YakBizzarro/marelleo/carte/marelleo.kicad_pcb

## KiCad design carte/marelleo.kicad_pcb (2026-11-06)

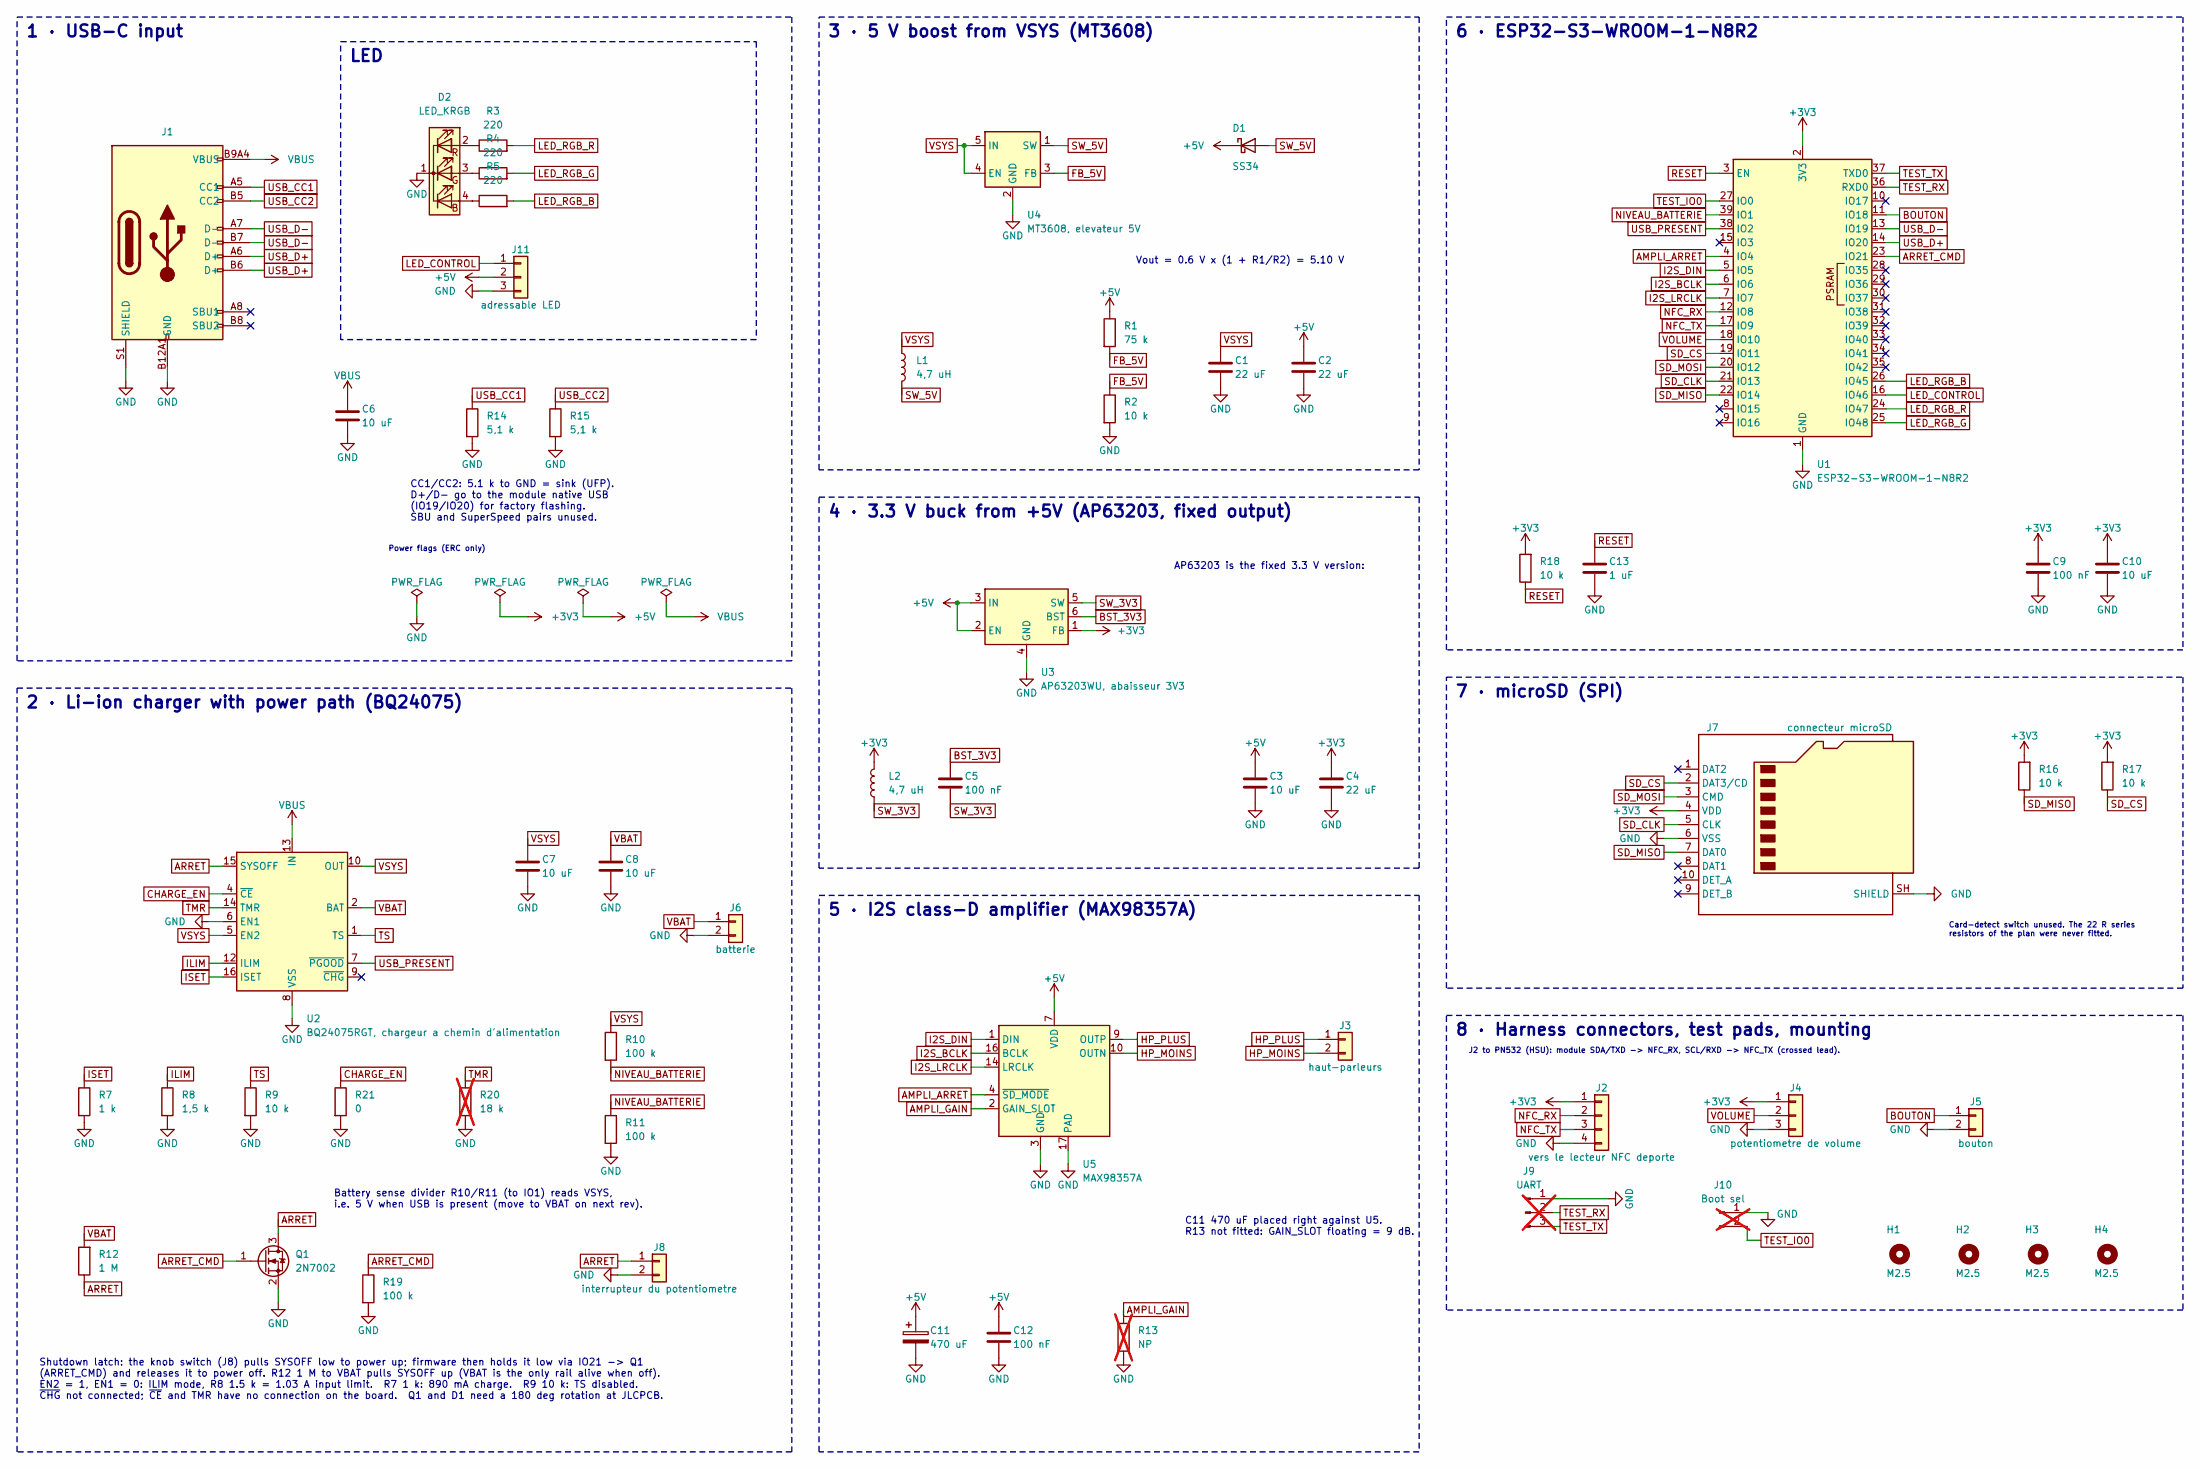
[picture p1: schematic marelleo.kicad_sch, Marelleo - main board]

Parts:
C1, C2, C4: 22 uF; C_0805_2012Metric; LCSC C45783
C3, C6, C7, C8, C10: 10 uF; C_0805_2012Metric; LCSC C15850
C5, C9, C12: 100 nF; C_0603_1608Metric; LCSC C14663
C11: 470 uF; CP_Elec_6.3x7.7; LCSC C82004
C13: 1 uF; C_0603_1608Metric; LCSC C15849
D1: SS34; D_SMA; LCSC C8678
D2: LED_KRGB; LED_D5.0mm-4_RGB_Wide_Pins
H1, H2, H3, H4: M2.5; MountingHole_2.7mm_M2.5
J1: Connector, USB-TYPE-C-16P; TYPE-C-SMD_HX-TYPE-C-16PIN; LCSC C2927039
J2: vers le lecteur NFC deporte; JST_PH_S4B-PH-K_1x04_P2.00mm_Horizontal; LCSC C157926
J3: haut-parleurs; JST_PH_S2B-PH-K_1x02_P2.00mm_Horizontal; LCSC C173752
J4: potentiometre de volume; JST_PH_S3B-PH-K_1x03_P2.00mm_Horizontal; LCSC C157929
J5: bouton; JST_PH_S2B-PH-K_1x02_P2.00mm_Horizontal; LCSC C173752
J6: batterie; JST_PH_S2B-PH-K_1x02_P2.00mm_Horizontal; LCSC C173752
J7: connecteur microSD; microSD_HC_Hirose_DM3AT-SF-PEJM5; LCSC C114218
J8: interrupteur du potentiometre; JST_PH_S2B-PH-K_1x02_P2.00mm_Horizontal; LCSC C173752
J9: UART; PinHeader_1x03_P2.54mm_Vertical; not fitted
J10: Boot sel; PinHeader_1x02_P2.54mm_Vertical; not fitted
J11: adressable LED; JST_PH_S3B-PH-K_1x03_P2.00mm_Horizontal; LCSC C157929
L1, L2: 4,7 uH; L_Taiyo-Yuden_MD-4040; LCSC C206284
Q1: 2N7002; SOT-23; LCSC C8545
R1: 75 k; R_0603_1608Metric; LCSC C23242
R2, R9, R16, R17, R18: 10 k; R_0603_1608Metric; LCSC C25804
R3, R4, R5: 220; R_0603_1608Metric
R7: 1 k; R_0603_1608Metric; LCSC C21190
R8: 1,5 k; R_0603_1608Metric; LCSC C22843
R10, R11, R19: 100 k; R_0603_1608Metric; LCSC C25803
R12: 1 M; R_0603_1608Metric; LCSC C22935
R13: NP; R_0603_1608Metric; not fitted
R14, R15: 5,1 k; R_0603_1608Metric; LCSC C23186
R20: 18 k; R_0603_1608Metric; LCSC C25804; not fitted
R21: 0; R_0603_1608Metric; LCSC C25804
U1: ESP32-S3-WROOM-1-N8R2; ESP32-S3-WROOM-1; LCSC C2913204
U2: BQ24075RGT, chargeur a chemin d'alimentation; VQFN-16-1EP_3x3mm_P0.5mm_EP1.1x1.1mm; LCSC C15464
U3: AP63203WU, abaisseur 3V3; TSOT-23-6; LCSC C780769
U4: MT3608, elevateur 5V; SOT-23-6; LCSC C84817
U5: MAX98357A; TQFN-16-1EP_3x3mm_P0.5mm_EP1.23x1.23mm; LCSC C910544

Connections:
+3V3: C4.1, C9.1, C10.1, J2.1, J4.1, J7.4 (VDD), L2.2, R16.2, R17.2, R18.2, U1.2 (3V3), U3.1 (FB)
+5V: C2.1, C3.1, C11.1, C12.1, D1.1 (K), J11.2, R1.1, U3.2 (EN), U3.3 (IN), U5.7 (VDD), U5.8 (VDD)
AMPLI_ARRET: U1.4 (IO4), U5.4 (~SD_MODE)
AMPLI_GAIN: R13.1, U5.2 (GAIN_SLOT)
ARRET: J8.1, Q1.3 (D), R12.1, U2.15 (SYSOFF)
ARRET_CMD: Q1.1 (G), R19.1, U1.23 (IO21)
BOUTON: J5.1, U1.11 (IO18)
BST_3V3: C5.1, U3.6 (BST)
CHARGE_EN: R21.1, U2.4 (~CE)
FB_5V: R1.2, R2.1, U4.3 (FB)
GND: C1.2, C2.2, C3.2, C4.2, C6.2, C7.2, C8.2, C9.2, C10.2, C11.2, C12.2, C13.2, D2.1 (K), J1.A12B1 (GND), J1.B12A1 (GND), J1.S1 (SHIELD), J2.4, J4.3, J5.2, J6.2, J7.6 (VSS), J7.SH (SHIELD), J8.2, J9.1, J10.1, J11.3, Q1.2 (S), R2.2, R7.2, R8.2, R9.2, R11.2, R13.2, R14.2, R15.2, R19.2, R20.2, R21.2, U1.1 (GND), U1.40 (GND), U1.41 (GND), U2.6 (EN1), U2.8 (VSS), U2.17 (VSS), U3.4 (GND), U4.2 (GND), U5.3 (GND), U5.11 (GND), U5.15 (GND), U5.17 (PAD)
HP_MOINS: J3.2, U5.10 (OUTN)
HP_PLUS: J3.1, U5.9 (OUTP)
I2S_BCLK: U1.6 (IO6), U5.16 (BCLK)
I2S_DIN: U1.5 (IO5), U5.1 (DIN)
I2S_LRCLK: U1.7 (IO7), U5.14 (LRCLK)
ILIM: R8.1, U2.12 (ILIM)
ISET: R7.1, U2.16 (ISET)
LED_CONTROL: J11.1, U1.16 (IO46)
LED_RGB_B: R5.2, U1.26 (IO45)
LED_RGB_G: R4.2, U1.25 (IO48)
LED_RGB_R: R3.2, U1.24 (IO47)
NFC_RX: J2.2, U1.12 (IO8)
NFC_TX: J2.3, U1.17 (IO9)
NIVEAU_BATTERIE: R10.2, R11.1, U1.39 (IO1)
unnamed: D2.4 (BA), R5.1
unnamed: D2.3 (GA), R4.1
unnamed: D2.2 (RA), R3.1
RESET: C13.1, R18.1, U1.3 (EN)
SD_CLK: J7.5 (CLK), U1.21 (IO13)
SD_CS: J7.2 (DAT3/CD), R17.1, U1.19 (IO11)
SD_MISO: J7.7 (DAT0), R16.1, U1.22 (IO14)
SD_MOSI: J7.3 (CMD), U1.20 (IO12)
SW_3V3: C5.2, L2.1, U3.5 (SW)
SW_5V: D1.2 (A), L1.2, U4.1 (SW)
TEST_IO0: J10.2, U1.27 (IO0)
TEST_RX: J9.2, U1.36 (RXD0)
TEST_TX: J9.3, U1.37 (TXD0)
TMR: R20.1, U2.14 (TMR)
TS: R9.1, U2.1 (TS)
USB_CC1: J1.A5 (CC1), R14.1
USB_CC2: J1.B5 (CC2), R15.1
USB_D+: J1.A6 (D+), J1.B6 (D+), U1.14 (IO20)
USB_D-: J1.A7 (D-), J1.B7 (D-), U1.13 (IO19)
USB_PRESENT: U1.38 (IO2), U2.7 (~PGOOD)
VBAT: C8.1, J6.1, R12.2, U2.2 (BAT), U2.3 (BAT)
VBUS: C6.1, J1.A9B4 (VBUS), J1.B9A4 (VBUS), U2.13 (IN)
VOLUME: J4.2, U1.18 (IO10)
VSYS: C1.1, C7.1, L1.1, R10.1, U2.5 (EN2), U2.10 (OUT), U2.11 (OUT), U4.4 (EN), U4.5 (IN)

Notes on the sheet:
Battery sense divider R10/R11 (to IO1) reads VSYS, i.e. 5 V when USB is present (move to VBAT on next rev).
Shutdown latch: the knob switch (J8) pulls SYSOFF low to power up; firmware then holds it low via IO21 -> Q1 (ARRET_CMD) and releases it to power off. R12 1 M to VBAT pulls SYSOFF up (VBAT is the only rail alive when off). EN2 = 1, EN1 = 0: ILIM mode, R8 1.5 k = 1.03 A input limit. R7 1 k: 890 mA c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
Card-detect switch unused. The 22 R series resistors of the plan were never fitted.
4 · 3.3 V buck from +5V (AP63203, fixed output)
1 · USB-C input
AP63203 is the fixed 3.3 V version:
3 · 5 V boost from VSYS (MT3608)
CC1/CC2: 5.1 k to GND = sink (UFP). D+/D- go to the module native USB (IO19/IO20) for factory flashing. SBU and SuperSpeed pairs unused.
Power flags (ERC only)
5 · I2S class-D amplifier (MAX98357A)
J2 to PN532 (HSU): module SDA/TXD -> NFC_RX, SCL/RXD -> NFC_TX (crossed lead).
LED
Vout = 0.6 V x (1 + R1/R2) = 5.10 V
6 · ESP32-S3-WROOM-1-N8R2
7 · microSD (SPI)
2 · Li-ion charger with power path (BQ24075)
C11 470 uF placed right against U5. R13 not fitted: GAIN_SLOT floating = 9 dB.
8 · Harness connectors, test pads, mounting

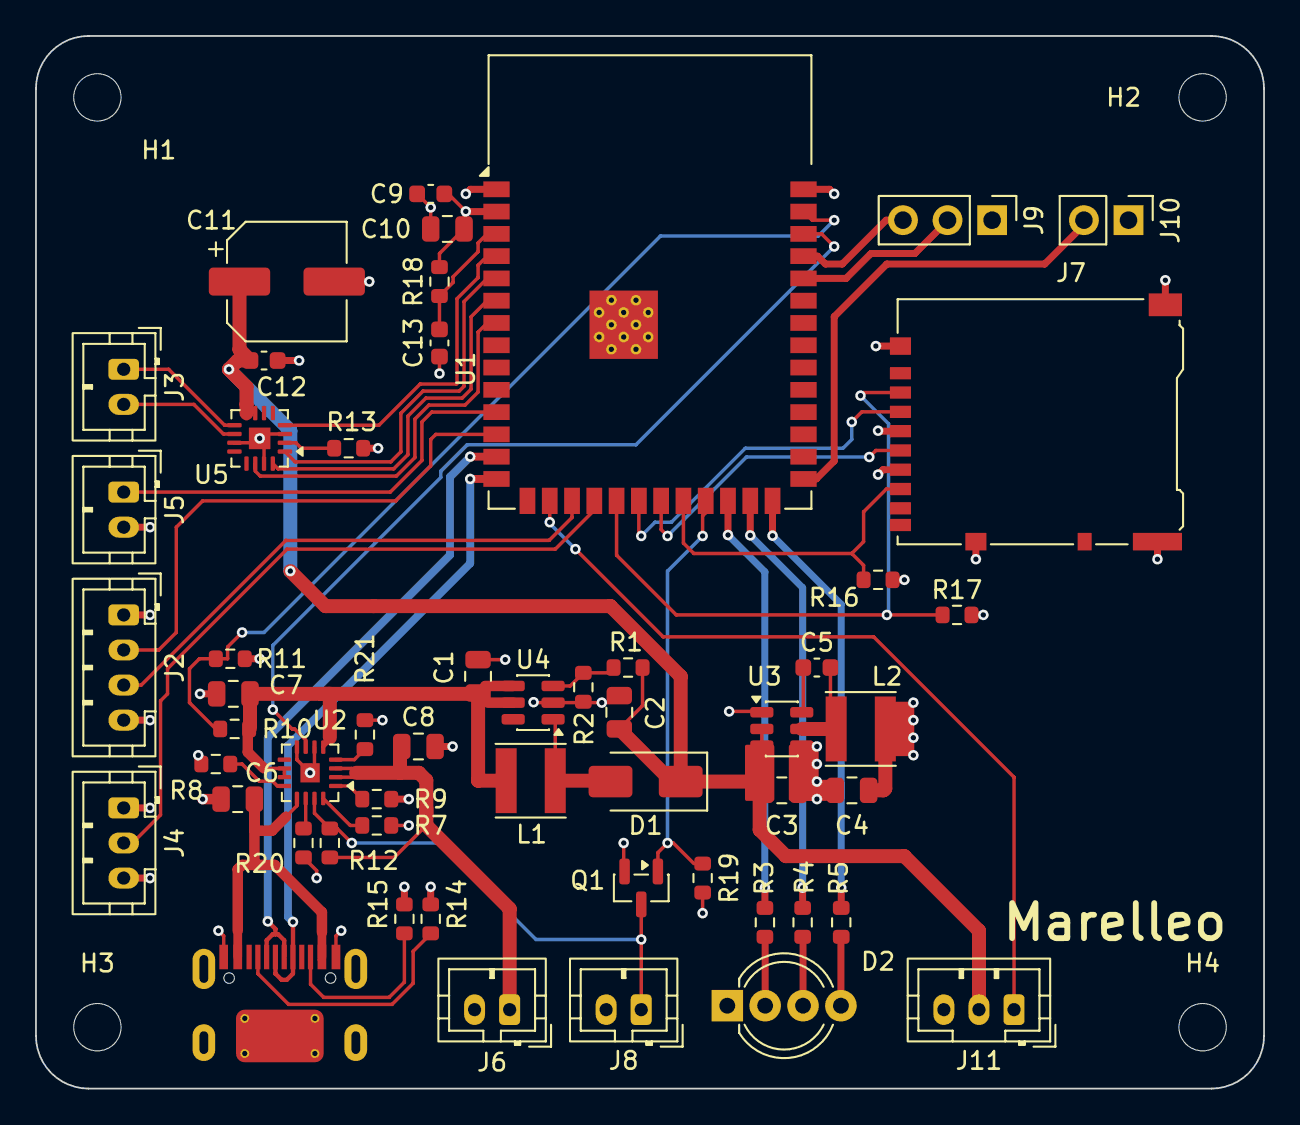
[picture p2: board marelleo.kicad_pcb from above]

Board: 4 copper layers, 70.0 x 60.0 mm, 58 parts (0 on the bottom side), 49 nets.
