YakBizzarro/marelleo/(commit log)

2026-11-03 Add AI-generated schematics, based from the layout and BOM
    Add two resitors (R20 and R21) to control correctly the BQ24075RGT.
    R21 enables the charging of the battery by tying /CE to GND.
    R20 control safety timers. It's left unpopulated to leave the default values.
    [marelleo.kicad_pcb, marelleo.kicad_sch]
2026-11-04 Use a header for UART and boot selector instead of test points
    [marelleo.kicad_pcb, marelleo.kicad_sch]
2026-11-04 Use vertical connectors for battery and potentiometer
    [marelleo.kicad_pcb]
2026-11-04 Correct 3.3V step down and redo its layout
    [marelleo.kicad_pcb, marelleo.kicad_sch]
2026-11-04 Remove 'ARRETE' line going nowhere
    [marelleo.kicad_pcb]
2026-11-04 Rework layout of step-down according to datasheet
    [marelleo.kicad_pcb]
2026-11-04 Move ESP32 decoupling capacitors close to 3.3V pin
    [marelleo.kicad_pcb]
2026-11-04 Rewwork layout of 5V generation
    [marelleo.kicad_pcb, marelleo.kicad_sch]
2026-11-05 Change USB connector to something cheaper. Move it to the left. USB lines are now matched to 90 ohm
    [marelleo.kicad_pcb]
2026-11-06 Add RGB LED
    [marelleo.kicad_pcb, marelleo.kicad_sch]
2026-11-06 Use only vertical connectors
    [marelleo.kicad_pcb]
2026-11-06 Add connector for adressable LEDs
    [marelleo.kicad_pcb, marelleo.kicad_sch]
